pons-deluxe/skate-following-underglow/images/schema20201027.png

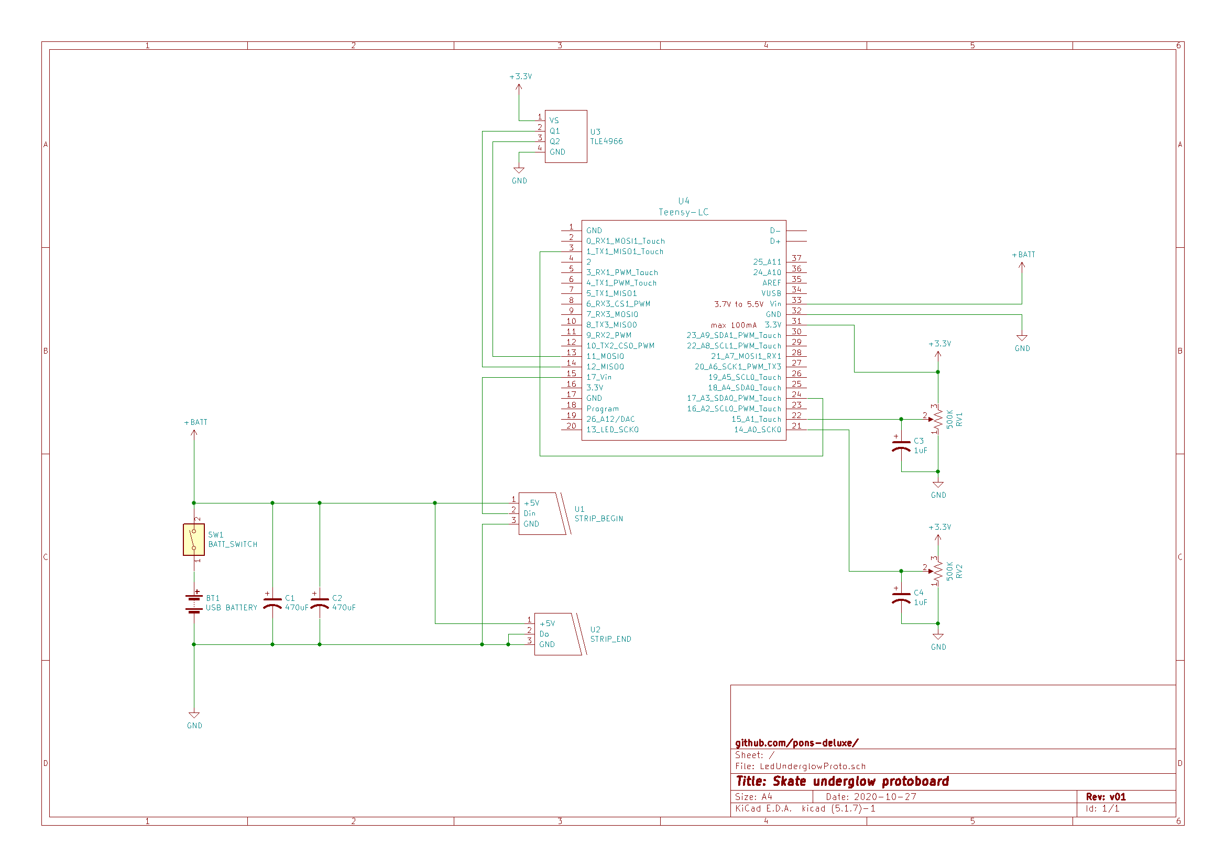
images/schema20201027.png
