pons-deluxe/skate-following-underglow/(commit log)

2020-09-30 add interrupt to be tested
2020-10-07 first working version with fake wheel
2020-10-15 trying to add a pot but broke speed detection
    [LedPatterns.cpp, LedPatterns.h, skate_underglow.ino]
2020-10-16 bug fix INPUT -> INPUT_PULLUP
    [skate_underglow.ino]
2020-10-19 change pin numbers for protoboard
2020-10-28 make board info a struct, reorder pattern arguments
